JellyTitan/SofleKeyboard/docs/images/build_guide_choc_mx/choc_mx_outline.png

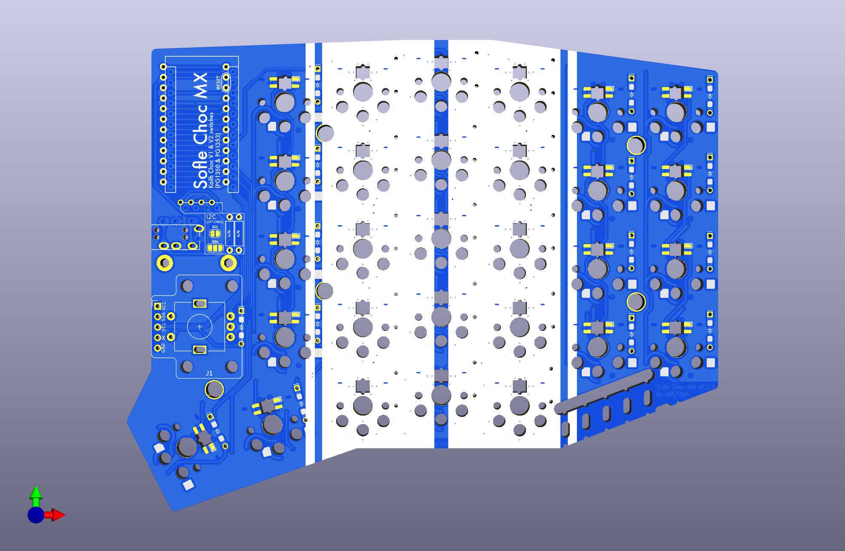
docs/images/build_guide_choc_mx/choc_mx_outline.png
