JellyTitan/SofleKeyboard/(list of files, drawings)

Other design files:
Sofle_Loud/Sofle_Loud/Sofle_Loud.dsn
