JellyTitan/SofleKeyboard/Sofle_Loud/Sofle_Loud/Sofle_Loud.kicad_sch

## KiCad design Sofle_Loud/Sofle_Loud/Sofle_Loud.kicad_sch (2023-05-07)

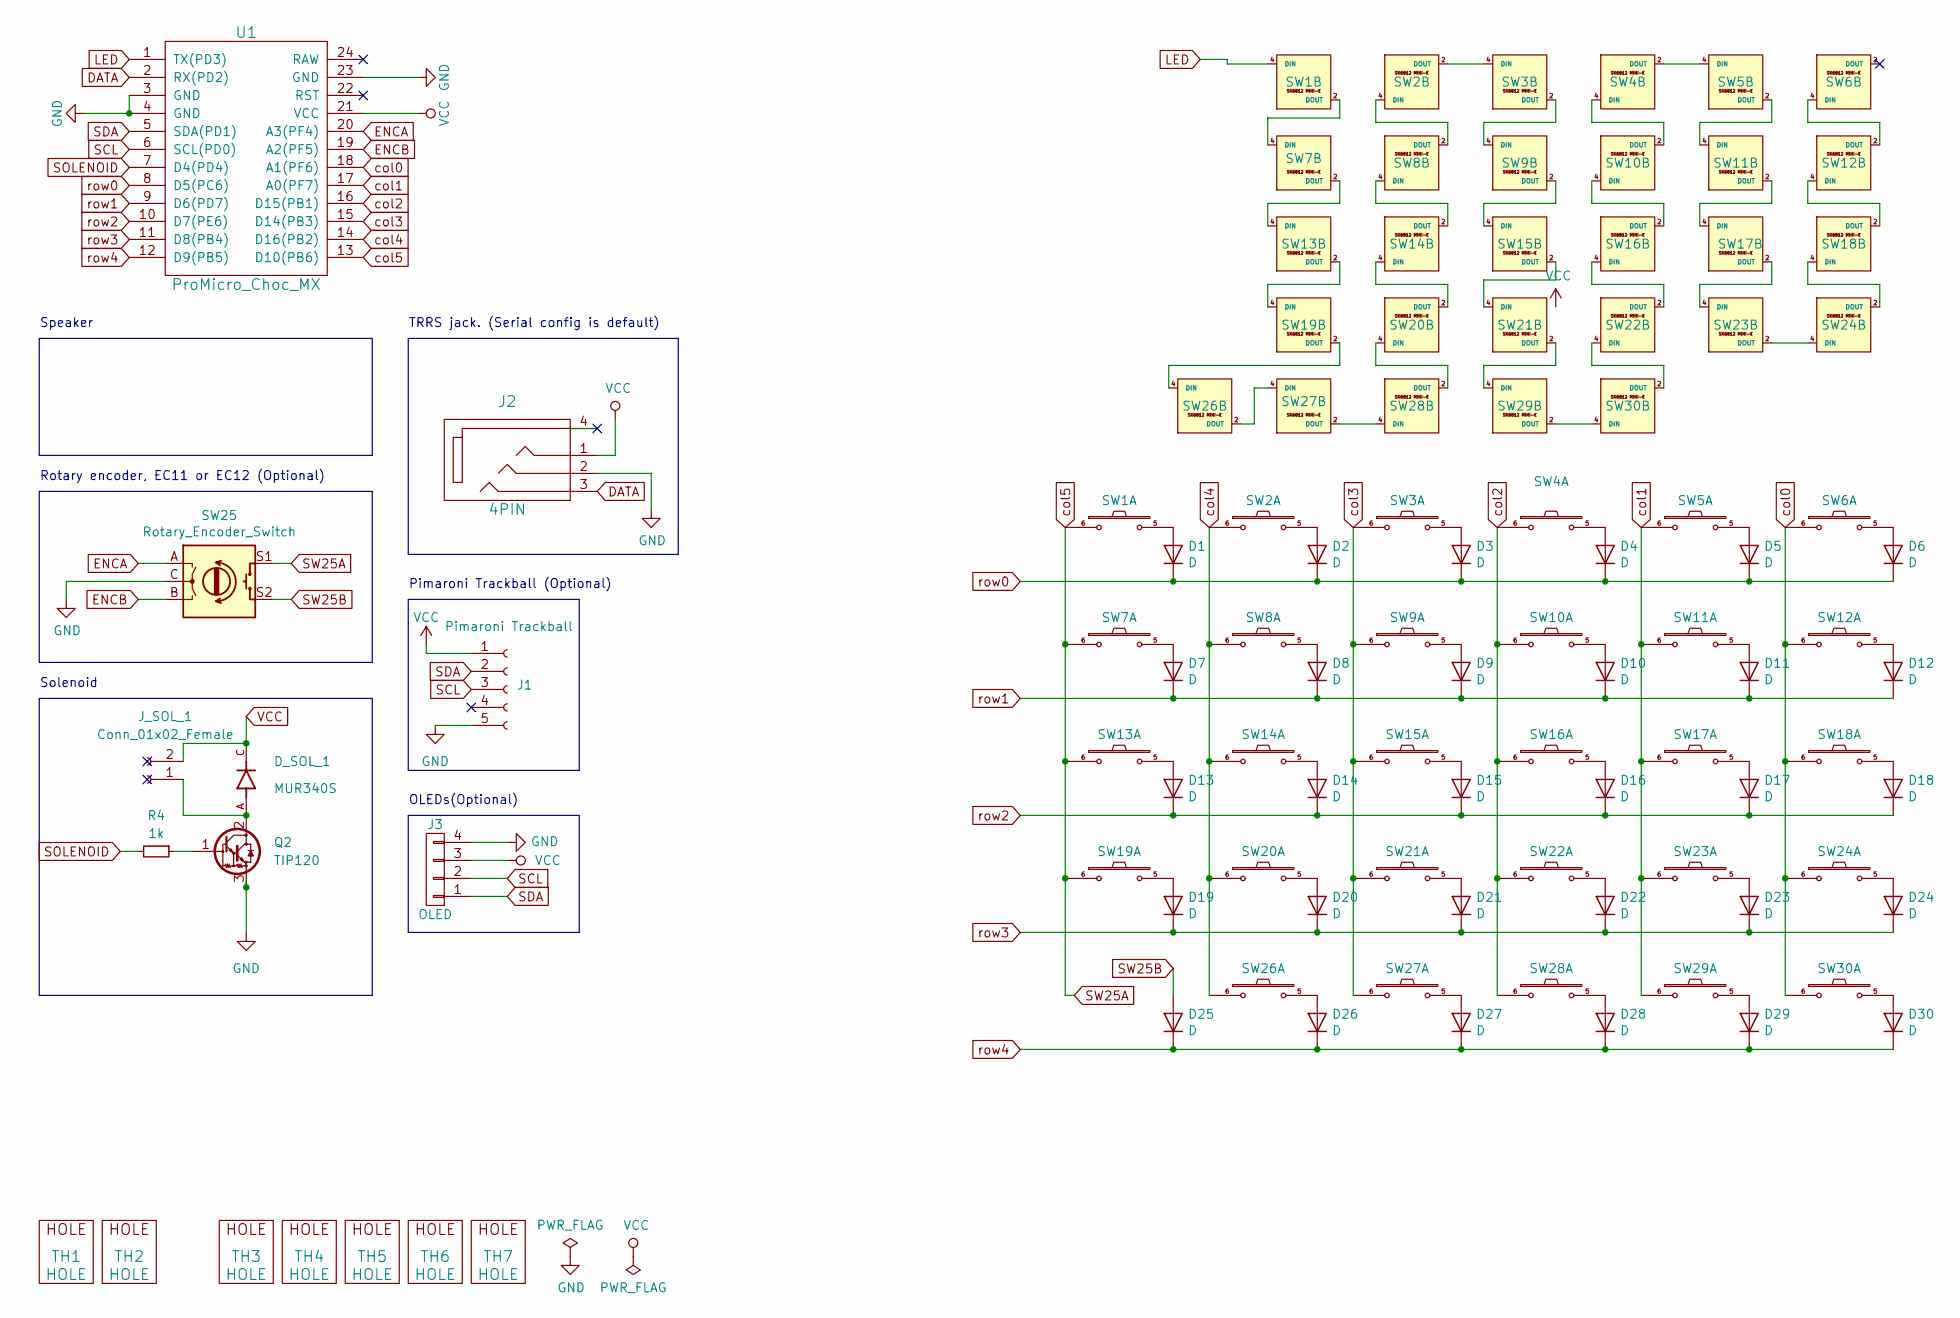
[picture p2: schematic Sofle_Loud.kicad_sch]

Parts:
D1, D2, D3, D4, D5, D6, D7, D8, D9, D10, D11, D12, D13, D14, D15, D16, D17, D18, D19, D20, D21, D22, D23, D24, D25, D26, D27, D28, D29, D30: D; D_SOD-123_DO-35_Hybrid_DoubleSided_V2
D_SOL_1: MUR340S; MUR340S_IN4001_TH_HYBRID; PARTREV L2102
J1: Pimaroni Trackball; Pimaroni_PinHeader_1x05_P2.54mm_Vertical
J2: 4PIN; TRRS_or_TRS_Sofle_Click
J3: OLED; OLED_4Pin_DS_64x128
J_SOL_1: Conn_01x02_Female; PinHeader_1x02_P2.54mm_L-Shaped
Q2: TIP120; TO-220-3_Horizontal_TabUp_noHeatsink
R4: 1k; R_Axial_DIN0309_L9.0mm_D3.2mm_P12.70mm_Horizontal
SW1, SW2, SW3, SW4, SW5, SW6, SW7, SW8, SW9, SW10, SW11, SW12, SW13, SW14, SW15, SW16, SW17, SW18, SW19, SW20, SW21, SW22, SW23, SW24, SW26, SW27, SW28, SW29, SW30: SW_PUSH_LED; Cherry_MX_DS_Hotswap_miniE_1U
SW25: Rotary_Encoder_Switch; RotaryEncoder_Alps_EC11E-Switch_Vertical_H20mm-keebio_modif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
TH1, TH2, TH3, TH4, TH5, TH6, TH7: HOLE; M2_HOLE_PCB_through_hole
U1: ProMicro_Choc_MX

Connections:
DATA: J2.3, U1.2 (RX(PD2))
ENCA: SW25.A, U1.20 (A3(PF4))
ENCB: SW25.B, U1.19 (A2(PF5))
GND: J1.5, J2.2, J3.4, Q2.3 (E), SW25.C, U1.3 (GND), U1.4 (GND), U1.23 (GND)
LED: SW1.4 (DIN), U1.1 (TX(PD3))
unnamed: D1.2 (A), SW1.5
unnamed: D2.2 (A), SW2.5
unnamed: D3.2 (A), SW3.5
unnamed: D4.2 (A), SW4.5
unnamed: D5.2 (A), SW5.5
unnamed: D6.2 (A), SW6.5
unnamed: D7.2 (A), SW7.5
unnamed: D8.2 (A), SW8.5
unnamed: D9.2 (A), SW9.5
unnamed: D10.2 (A), SW10.5
unnamed: D11.2 (A), SW11.5
unnamed: D12.2 (A), SW12.5
unnamed: D13.2 (A), SW13.5
unnamed: D14.2 (A), SW14.5
unnamed: D15.2 (A), SW15.5
unnamed: D16.2 (A), SW16.5
unnamed: D17.2 (A), SW17.5
unnamed: D18.2 (A), SW18.5
unnamed: D19.2 (A), SW19.5
unnamed: D20.2 (A), SW20.5
unnamed: D21.2 (A), SW21.5
unnamed: D22.2 (A), SW22.5
unnamed: D23.2 (A), SW23.5
unnamed: D24.2 (A), SW24.5
unnamed: D26.2 (A), SW26.5
unnamed: D27.2 (A), SW27.5
unnamed: D28.2 (A), SW28.5
unnamed: D29.2 (A), SW29.5
unnamed: D30.2 (A), SW30.5
unnamed: D_SOL_1.A, J_SOL_1.1, Q2.2 (C)
unnamed: Q2.1 (B), R4.1
unnamed: SW1.2 (DOUT), SW7.4 (DIN)
unnamed: SW2.2 (DOUT), SW3.4 (DIN)
unnamed: SW2.4 (DIN), SW8.2 (DOUT)
unnamed: SW3.2 (DOUT), SW9.4 (DIN)
unnamed: SW4.2 (DOUT), SW5.4 (DIN)
unnamed: SW4.4 (DIN), SW10.2 (DOUT)
unnamed: SW10.4 (DIN), SW16.2 (DOUT)
unnamed: SW11.2 (DOUT), SW17.4 (DIN)
unnamed: SW5.2 (DOUT), SW11.4 (DIN)
unnamed: SW6.4 (DIN), SW12.2 (DOUT)
unnamed: SW12.4 (DIN), SW18.2 (DOUT)
unnamed: SW13.2 (DOUT), SW19.4 (DIN)
unnamed: SW7.2 (DOUT), SW13.4 (DIN)
unnamed: SW8.4 (DIN), SW14.2 (DOUT)
unnamed: SW14.4 (DIN), SW20.2 (DOUT)
unnamed: SW15.2 (DOUT), SW21.4 (DIN)
unnamed: SW9.2 (DOUT), SW15.4 (DIN)
unnamed: SW16.4 (DIN), SW22.2 (DOUT)
unnamed: SW17.2 (DOUT), SW23.4 (DIN)
unnamed: SW18.4 (DIN), SW24.2 (DOUT)
unnamed: SW19.2 (DOUT), SW26.4 (DIN)
unnamed: SW20.4 (DIN), SW28.2 (DOUT)
unnamed: SW21.2 (DOUT), SW29.4 (DIN)
unnamed: SW22.4 (DIN), SW30.2 (DOUT)
unnamed: SW23.2 (DOUT), SW24.4 (DIN)
unnamed: SW26.2 (DOUT), SW27.4 (DIN)
unnamed: SW27.2 (DOUT), SW28.4 (DIN)
unnamed: SW29.2 (DOUT), SW30.4 (DIN)
SCL: J1.3, J3.2, U1.6 (SCL(PD0))
SDA: J1.2, J3.1, U1.5 (SDA(PD1))
SOLENOID: R4.2, U1.7 (D4(PD4))
SW25B: D25.2 (A), SW25.S2
VCC: D_SOL_1.C, J1.1, J2.1, J3.3, J_SOL_1.2, SW21.1 (VDD), U1.21 (VCC)
col0: SW6.6, SW12.6, SW18.6, SW24.6, SW30.6, U1.18 (A1(PF6))
col1: SW5.6, SW11.6, SW17.6, SW23.6, SW29.6, U1.17 (A0(PF7))
col2: SW4.6, SW10.6, SW16.6, SW22.6, SW28.6, U1.16 (D15(PB1))
col3: SW3.6, SW9.6, SW15.6, SW21.6, SW27.6, U1.15 (D14(PB3))
col4: SW2.6, SW8.6, SW14.6, SW20.6, SW26.6, U1.14 (D16(PB2))
col5: SW1.6, SW7.6, SW13.6, SW19.6, SW25.S1, U1.13 (D10(PB6))
row0: D1.1 (K), D2.1 (K), D3.1 (K), D4.1 (K), D5.1 (K), D6.1 (K), U1.8 (D5(PC6))
row1: D7.1 (K), D8.1 (K), D9.1 (K), D10.1 (K), D11.1 (K), D12.1 (K), U1.9 (D6(PD7))
row2: D13.1 (K), D14.1 (K), D15.1 (K), D16.1 (K), D17.1 (K), D18.1 (K), U1.10 (D7(PE6))
row3: D19.1 (K), D20.1 (K), D21.1 (K), D22.1 (K), D23.1 (K), D24.1 (K), U1.11 (D8(PB4))
row4: D25.1 (K), D26.1 (K), D27.1 (K), D28.1 (K), D29.1 (K), D30.1 (K), U1.12 (D9(PB5))

Notes on the sheet:
TRRS jack. (Serial config is default)
Pimaroni Trackball (Optional)
Rotary encoder, EC11 or EC12 (Optional)
Solenoid
OLEDs(Optional)
Speaker
