JellyTitan/SofleKeyboard/docs/build_guide_click.md

---
layout: default
title: Sofle Keyboard - build guide (Click)
---

Keyboard
BUILD LOG UPDATE:
5-22-23
Lessons learned/TODO 
* Diode is under keyplate, harder to solder. Can it go elsewhere?
* Soleniod jack is at a dumb spot. it sticks out either way. tuck it up under so you can use dupont connectors.
* The aluminum finish is weird where you tried to go "No solder mask" on the aluminum plates. Maybe a primer? Just do normal stuff
* The USB-c promicro sticks out farther than micro usb.
* The 4 holes in the keyplate need to be smaller, otherwise the posts go through, and that sucks.

BUILD LOG UPDATE:
5-7-23
* Revised Main board outline
* Solenoid should now attach to bottom plate
* Removed speaker 
* Rerouted for new plate cutouts
* Added puck tenting

@todo:
* rebuild all plates with solenoid attached to bottom
* add gold rimmed holes
* Swap in 64x128 screens
* Wait for pico test board to come in.

The Sofle Click is a variant of the Sofle V2 that uses Cherry MX Hot swap switches, supports RGB, 128x64 OLEDs, Solenoids, & piezzo buzzers.

This guide is based off the [http://choc.brianlow.com](Sofle Choc guide by Brian Low). The components are layed out in a similar fashion.

Like the standard Sofle:
  - Hotswap sockets are required. 
  - Per-key RGB remains optional and uses the relatively easy to solder SK6812 MINI-E LEDs.
  - The ProMicro pinout has _not_ changed, so both versions use the same firmware.
  - Key placement has not changed.

This is similar to the Sofle RGB.
I rerouted this board for simplification, and ease of assembly/manufacture were prioritized.
I removed the optional I2C bus so that a TRRS or TRS cable could be used.

Differences from the Sofle V2:
   - Added drill holes above the mini-e hole to allow for easier tweezer placement.
   - Collapsed the double promicro footrpint to a single footprint to simplify routing. (One halfe of the board now has the promicro face up, the other face down.)
   - Added through-hole/Surface mount hybrid footprints for the per-switch diodes.
   - Removed I2C Bus implementation.
   - Moved _all_ mounting holes, both those between keys and those used for the screen cover.
   - Modified thumb cluster outline to accommodate 1.25u thumb keycap.
   - Rounded board corners with a consistent radius. 
   - Added clearly labeled and easily accessible [Pimoroni trackball](https://shop.pimoroni.com/en-us/products/trackball-breakout) tie in footprint.
   - Added teardrops to decrease likelihood of acid traps during manufacture.
   - Added a VCC net to simplify routing.
   - Poka-yoke TRRS footprint by removing unnecessary solder masks.
   - Tweaked diode placement & improved labeling for easier troubleshooting.
   - Removed reset switch and added reset labels. (Modern QMK can put the Promicro into bootloader mode with 'QK_BOOT' key. The hardware reset button would likely only be used once, if at all. There are now labels on the board to short the pins directly if a reset is needed).
   - Resolved the bulk of KiCad DRC violations. (A few edge clearance violations remain - but nothing electrically relevant).
   - @todo Added rally stripes
   - @todo add vent holes in tier 3 plates?
   
Regarding top plates:
   - The top plates from Sofle v1, v2, RGB and Choc versions are not compatible, because the mounting holes have moved to accommodate Choc V2 footprints.
   - The solenoid & the screen are taller than the switch plate, so they have their own separate taller plates.
   - Spacers are intended to pass through the main pcb and screw onto the bottom plates, top plates, and solenoid/oled plates. 

The Sofle Click was designed by [Ryan Neff](https://github.com/JellyTitan), based on the excellent Sofle Choc designed by [Brian Low](https://github.com/brianlow), that is based on the fantastic Sofle RGB by [Dane Evans](https://github.com/DaneEvans) which was based on the original Sofle v2 by [Josef Adamčík](https://github.com/josefadamcik). The Choc V2 footprints came from the well-regarded foostan [kbd library](https://github.com/foostan/kbd). 

## Updated Build Guide and Kits

@todo - write this.

## Bill of materials

The following is needed to build the keyboard:

- **2 PCBs**. Send the zip from `/Gerbers/Choc_mx/choc-mx-gerber-pcb.zip` to a PCB fabrication service. 
The PCB should be 1.6mm thick. I used JLCPCB's default settings only customizing the PCB color. 
@todo refresh Gerbers and update path
@todo: Mention "Lead free" 
@todo: Mention Jlcpcbpart number placement
@todo: seperate jlcpcb gerber?
@todo: revise this -> See [sourcing][sourcing].

- **2 Pro Micro** boards or clones. 5v, 2x12 pins, ATmega32U4 microcontroller. **Don't** buy the Arduino Micro (a different pinout) or Arduino Mini (different microcontroller). You could also use Elite-C which basically Pro Micro with USB-C.
Although QMK supports conversion to pi2040 boards, they are usually not 5v tolerant and may cause issues with the LED's. 
@todo verify this.

- **4x 12 pin headers (and optional sockets)** for Pro Micros. There are several ways to mount Pro Micros to the board. The male pin headers you most likely got with the board can be used to solder it directly to the board. This makes it hard to replace the board if it fails. The micro-USB connector is known to tear off. ~~I socketed the Pro Micro using the diode legs approach [described at splitkb.com][promicrosocketing] with two 12-pin female headers. This is the option descibed in the build guide here. Lastly, [these spring pin headers][springpinheader] are used on similar keyboards and should give a compact, non-permanent connection but have been out of stock for a long time.~~
@todo link to cheap sockets

- **58 Kailh Choc keyboard switches**. Must be [Kailh Choc v1 switches (PG1350)](https://deskthority.net/wiki/Kailh_PG1350_series) of any color, or [Kailh Choc v2](https://deskthority.net/wiki/Kailh_PG1353_series) of any color. The `PG` prefix is often omitted. **Don't** buy , [Kailh Mini Choc](https://deskthority.net/wiki/Kailh_PG1232_series) or [Cherry MX](https://deskthority.net/wiki/Cherry_MX).

- **58 Kailh Choc keyboard switch sockets**. Sockets are specific to the PG1350 switch. The PCB requires sockets. Switches cannot be soldered directly to the board.

- **58 keycaps**. You can use either all in `1u` size but it looks nicer with two `1.5u` for the thumb keys.
@todo link to choc v1 and choc v2 caps. 
@todo - I heard that some MX caps dont' work with choc v2?

- **58 diodes**. 
  -- Surface Mount: 1N4148W surface mount diodes in SOD123 package. Pick any common variation. I used `1N4148WTR` (Digi-Key 1655-1360-1-ND).
  
  Alternately, you can use through  hole diodes, which are easier to solder. These will be _mostly_ hidden under mx keycaps. 
  @todo - modify thumb cluster diode placement? What about rotary diode?
  
  -- Through hole: 1N4148 through hole diode. These are common, any old one should do.

- **2 TRRS connectors**. The same type which is used for Corne, Lily58 etc. Technically even TRS should work if you stick to the default serial communication.

- **1 TRRS cable**. TRS should work if you stick with the default serial communications.

- **8 - 10 silicone bumpers**. Used for feet to keep the keyboard from moving

- **Micro USB Cable** to connect the keyboard to a computer.

Optional components:

- **OLED/s**
  - **2 SSD1306 128x32 OLED display module**. 4-pin, I2C, 0.91". Very common.
  @todo - can we upgrade to 128x64?
  - **2x 4 pin header (and optionally socket)** for OLEDs. These came pre-soldered to the OLED unit. You can solder the OLED directly to the board. Ideally use a socket so you can replace and/or get at the ProMicro underneath. I found 4 pin female headers with half height (~4mm) insulation worked well
  - **2 OLED covers** This should be compatible with the Sofle RGB cover but have not verified
  @todo design these

- **Rotary encoders**
  - **2 Rotary encoders EC11**. If you are not sure take EC11E. Some other variants (EC11K) may have some additional plastic pins for and require mounting holes for them which are not included on the PCB. 
  The standard shaft height is 20mm. For choc low-profile keycaps, this is great. For the taller profile MX keycaps, you lose most of that shaft height, so i would recomend a taller shaft if you can find it. I prefer the Keebio EC11 basic for 20mm shaft. You can find taller shafts at Mouser or Aliexpress. I've yet to find an encoder i don't like. Recently EC12 low-profile encoders have become widely available. They do not have the push switch like the ec11, but otherwise they fit in the same footprint. 
  - **2 matching knobs** for each encoder. Make sure the knob matches the encoder's shaft diameter, depth and shape.
  - **2 diodes 1N4148W SMD or 1N4148 through-hole** the EC11 encoder shafts are pushable and can be used as configurable keys.

- **LEDs**
  - **58 SK6812 MINI-E RGB LEDs**. The LED body 3.2x2.8x1.7mm and with legs is 5.8x2.8. Avoid the non-MINI-E version without the legs. Purchase extra as they are delicate. If you have the option to use a heat gun and solder paste, this makes the install easier. Alternately, you can pay the pcb manufacturer to add them. 

- **Resistors**
  - **2x 4.7kOhm through hole resistors** These only needed if you want to use the less common I2C communication protocol between halves. They are installed in the R1/R2 spots. I have not tested an I2C setup. The firmware on this page uses serial communication and does not require the resistors.

Components that are common on other Sofle variants but are **not** used on this Sofle Choc MX: bottom plate, top plate, M2 spacers and screws.

@todo - rewrite left off here <<<<<
## Tools and materials

- soldering iron and solder
- no-clean flux makes soldering easier
- solder wick or desoldering pump to correct mistakes
- good tweezers
- flush cutters to trim diode legs when socketing the ProMicro
- masking, kapton or electrical tape
- isopropyl-alcohol for cleaning
- screwdriver
- 1.5mm hex key for the set screw on the encoder knob
- multimeter for troubleshooting

## Steps

### Prepare

Make sure you know which side you are working on, and don't make two left hand sides by mistake. Stick a piece of tape on the front side of both PCBs to help remember.

This guide is written in the order I like to install components.

We will start with the components on the back, shortest to tallest:
  - diodes
  - LEDs
  - switch sockets

Then install the components on the front:
  - OLED jumpers
  - ProMicro & socket
  - OLED & socket
  - reset switch
  - TRRS connector
  - encoder

The order of assemby does not matter **except** for these 3 components because they stack on top of one another:
  1. the four OLED jumpers
  2. the Pro Micro
  3. the OLED screen

The build guides for the Sofle and Sofle RGB have some good tips and photos. However there are differences so use this page as your primary reference. In particular, use the ProMicro orientation described on this page.

### Switch Sockets and Diodes

Switch sockets and diodes

These components are placed on the back of the PCB.

Diodes must be oriented with the white band in the direction of the "arrow" symbol on the PCB. I typically tin one pad, place the diode on, apply the soldering iron to the diode leg until it melts the solder underneath and sinks flush with the PCB. Then come back and solder the other leg.

The sockets are the largest and easiest to solder. They are installed on the back of the PCB facing up towards the front of the PCB. Make sure they are flush with the PCB. Heat the metal connector, apply solder and look for the solder to wick down to the PCB. You want a solid joint since this may take some mechanical strain from switch installation and removal.

### The LEDs

LED

LEDs are placed on the back of the PCB. The lens should point up through the PCB so they shine into the bottom of the switch. One leg will have a diagonal cut. This cut leg should be aligned with the triangular marking on the PCB.

To solder: tin one pad, place the LED and hold using tweezers, apply heat to the leg until the solder melts and the LED is flush with the board. Now the remaining legs can be soldered without the component moving. The LEDs are sensitive to heat. Let the LED cool between soldering each leg. Use the lowest heat needed for your solder.

The LEDs are wired in one long chain. If a LED is not working, replace the LED and the LED preceeding it. Sometimes just the output of a LED is damaged. The full chain does not need to be installed if you want to test a partially built board.

LED

### OLED Jumpers

OLED Jumpers

Now we move to the front of the PCB.

The jumpers in the photo should be bridged if using an OLED dispay. The jumpers may not be accessible later in the build depending on how the Pro Micro is attached. Bridge the jumpers on the top side of the board, the same side the ProMicro will be mounted on.

### Pro Micro

Pro Micro

The Pro Micro is installed on the top of the board, upside down and in the marked holes.

* Top of the board: this is the side of the PCB opposite the diodes, LEDs and switch sockets
* Upside down: both Pro Micro components should face the PCB with the mostly plain back facing out
* Marked holes: there are two sets of holes in the PCB, use the holes with the rectangular outline on the top of the board

Double-check your work here. This step is hard to reverse if a mistake is made.

To install a socketed Pro Micro using the diode leg approach [from splitkb.com][promicrosocketing]:

  1. Install the 12-pin female headers on the top of the board in the outlined through holes. Use some tape to temporarily tack them in place. Flip the board over onto a flat, hard surface. While soldering the first pins, push down on the PCB to ensure the headers are perpendicular and fully seated.

  2. Flip the board upright again. Optionally place some tape over the sockets to protect against fusing parts together. Place the Pro Micro upside down on top. Push diodes though the Pro Micro holes, through the tape and seated into the socket below.

  3. Solder the legs to the Pro Micro. Snip off the legs above the Pro Micro.

If you ever need to remove the Pro Micro: do it by gently prying the board up in small increments, working your way around the board. Avoid pressure on the USB connector. The diode leags are quite weak and will usually bend if you pull the Pro Micro off in one action.

### OLED

Install the OLED so it overhangs the Pro Micro. I added electrican's tape to the bottom of the OLED module where it might contact the Pro Micro.

If you are socketing the OLED, install the 4 pin, half height female header on the top of the PCB. Then push the OLED pins into the socket. You may need to trim the OLED pins so the insulation on the female and male headers mate and the OLED sits just above the Pro Micro. The downside to socketing is the OLED isn't as secure in the half height socket. When turning the keyboard upside down I find the OLED will lever away from the Pro Micro somewhat.

### Solder misc components

Use tape to tack each component in place while flipping the board over to solder.

Solder the TRRS connector. You may need to bend the TRRS connector pins 90 degrees so they point down into the PCB. The R1 and R2 locations should remain empty.

Solder the encoder.

### Assemble

- Snap a few switches into the top plate, the corner switches work best

- Place the PCB on a flat surface. This will save some strain on the solder joints in the next step (though they should be able handle it).

- Carefully lower the top plate with switches on the main PCB and push into sockets. Ensure pins are aligned.

- Snap the remaining switches into the top plate pressing into the sockets.

- There are no standoff between the PCB and top plate

- Place the encoder knob on the shaft. Tighten the set screw with a hex key. A small screwdriver for glasses may do in a pinch.

- Optionally add oled covers

- Put at least 4 adhesive rubber feet in the corners so the keyboard is not moving when you type.

## Warnings and disclaimers

- Don't connect or disconnect the TRRS cable when the keyboard is powered. It may short out. Always disconnect the USB cable first.
- Be gentle with micro USB ports on your microcontrollers. They are easy to break.
- Keep in mind that this is a prototype of a DIY keyboard. It's not a polished product.

## Firmware and programming

The Sofle Choc uses [QMK Firmware][qmk_firmware]. Support is not in the main QMK repository [yet](https://github.com/qmk/qmk_firmware/pull/16736). Instead use the [brianlow/qmk_firmware](https://github.com/brianlow/qmk_firmware) fork.
Suggested approach is to build the firmware yourself. You should be familiar with QMK and be able to make it work on your local environment. If not, please [follow the instructions in the documentation][qmkintro]. Note QMK setup is fairly invasive (upgrade every homebrew package on your system) so you might want to consider the [QMK Docker image](https://beta.docs.qmk.fm/using-qmk/guides/development-environments/getting_started_docker) for compiling.

To flash:

- Clone [https://github.com/brianlow/qmk_firmware](https://github.com/brianlow/qmk_firmware)
- Switch to the `choc2` branch with `git checkout choc2`
- Make sure your QMK environment [is setup][qmkintro].
- Make sure halves are not connected together with TRRS cable.
- Connect one half to USB, flash the firmware (always follow the current instructions in the QMK documentation! The command might look something like this: `qmk flash -kb sofle_choc -km default`). Use the reset button to reset the keyboard when you are asked to in console. Some Pro Micros require double-clicking the reset button to enter bootloader mode.
- Connect the second half and flash it in the same way as the previous one.
- Disconnect the USB cable. Connect both halves together with TRRS cable.
- Connect USB cable to the **left** side.
- Enjoy SofleKeyboard!

There is also a firmware version that uses [VIA](https://caniusevia.com/). VIA allows you to quickly change your keymap without flashing or a QMK build environment. I highly recommend it for experimenting. There are few downsides:
- it doesn't support custom logic like a key for switching betwen Mac/Win
- the exporting/importing keymaps has some problems with some multi-chord keys though typically I don't find I need to export/import
- lighting configuration keys only seem to affect lighting on the master side. If you don't change lighting much, a workaround is to plug just the right side in to the computer, change the lighting then plug everrything back normally

To use the VIA firmware

- Clone https://github.com/brianlow/qmk_firmware
- Switch to the `choc-brian` branch with `git checkout choc-brian`
- When flashing use the `choc_brian` keymap: `qmk flash -kb sofle/rev1 -km choc-brian`
- Download the VIA app from https://caniusevia.com/, it should recognize the keyboard when it opens

## Troubleshooting

See the Sofle build guide.

## Links

- [Github with KiCad projects][soflegithub]
- [Layout in KeyboardLayout editor][soflechoclayout]
- [QMK Firmware][qmk_firmware]
- [QMK Configurator][qmk_configurator]

## Default layout

The default layout for the Sofle Choc is in the QMK fork and demonstrates some LED functions.

Default layout for Sofle Choc Keyboard

## Images of keyboard

Keyboard Photo 1

Keyboard Photo 2

## Version History

* v2.1.1 - Top plate: moved the version label to less visible location, widened the area above the encoder. PCB version remains at v2.1
* v2.1 - First published version

## Footnotes
[layoutarticle]: <https://josef-adamcik.cz/electronics/in-search-of-the-best-custom-keyboard-layout.html> "In search of the best custom keyboard layout"
[introductionarticle]: <https://josef-adamcik.cz/electronics/let-me-introduce-you-sofle-keyboard-split-keyboard-based-on-lily58.html> "Let me introduce you SofleKeyboard - a split keyboard based on Lily58 and Crkbd"
[soflelayout]: http://www.keyboard-layout-editor.com/#/gists/76efb423a46cbbea75465cb468eef7ff "Sofle Keyboard layout at keyboard-layout-editor.com"
[soflechoclayout]: http://www.keyboard-layout-editor.com/#/gists/5604075ad16c10a8c634828c5911d2b6 "Sofle Choc Keyboard layout at keyboard-layout-editor.com"
[soflegerber]: https://github.com/josefadamcik/SofleKeyboard/releases "SofleKeyboard - gerber files"
[qmk_firmware]: https://github.com/qmk/qmk_firmware/ "QMK firmware"

[qmk_configurator]: https://config.qmk.fm/#/sofle/rev1/LAYOUT "QMK configurator"
[springpinheader]: <https://yushakobo.jp/shop/a01mc-00/> "Spring pin headers - Japanese"
[qmkprotonc]: https://qmk.fm/proton-c/ "QMK Proton-C"
[promicrosocketing]: <https://docs.splitkb.com/hc/en-us/articles/360011263059> "How do I socket a microcontroller? by splitkb.com"
[qmkintro]: <https://beta.docs.qmk.fm/newbs/newbs_getting_started> "QMK getting started"
[qmkhandedness]: <https://docs.qmk.fm/#/feature_split_keyboard?id=setting-handedness> "QMK firmware - setting handedness"
[manufacturingproblems]: https://josef-adamcik.cz/electronics/corne-keyboard-build-log.html#manufacturing-at-jlcpcb---update-27112019 "Possible problems when manufacturing top plate for Corne"
[nooledlag]: https://github.com/qmk/qmk_firmware/issues/7522 "No OLED lag bug"
[soflegithub]: https://github.com/josefadamcik/SofleKeyboard "SofleKeyboard - KiCad project on Github.com"
[sourcing]: <{{ site.baseurl }}/sourcing_parts.html> "Sourcing parts"
