JellyTitan/SofleKeyboard/(commit log)

2023-03-18 Cloned ChocV2 MX variant from sofle choc Replaced Choc V1 footprints with Choc V2 footprints
    [SofleKeyboard.dsn, SofleKeyboard.kicad_pcb, SofleKeyboard.sch, SofleKeyboardTopPlate.kicad_pcb]
2023-03-18 Tied front zone to VCC Updated LED footprint with compact DS variant
    [SofleKeyboard.kicad_pcb]
2023-03-18 Swapped out SMD Diode footprint for through-hole SMD hybrid footprint
    [SofleKeyboard.kicad_pcb, SofleKeyboard.kicad_sch]
2023-03-18 Wiped switch vias and traces for reroute
    [SofleKeyboard.kicad_pcb]
2023-03-18 Diodes moved to prevent footprint overlaps
    [SofleKeyboard.kicad_pcb]
2023-03-19 Switch footprint overhaul switch rerouteing
    [SofleKeyboard.kicad_pcb]
2023-03-19 More routing
    [SofleKeyboard.kicad_pcb]
2023-03-20 Switch footprint rework for consistent clearance
2023-03-20 Hole size tweaks for JLCPCB and DRC
2023-03-20 ProMicro footprint variant created backside shifted .25 -x to resolve DRC clearance violations
2023-03-20 Created TRRS footprint variant Poka-yoke by removing unnecessary trrs masks
    [SofleKeyboard.kicad_sch]
2023-03-20 Revised mini-e footprint for elegant routing
2023-03-21 Sent this version out for production at jlcpcb
    [SofleKeyboard-B_Cu.gbl, SofleKeyboard-B_Mask.gbs, SofleKeyboard-B_Silkscreen.gbo, SofleKeyboard-Edge_Cuts.gm1, SofleKeyboard-F_Cu.gtl, SofleKeyboard-F_Mask.gts, SofleKeyboard-F_Silkscreen.gto, SofleKeyboard-NPTH.drl]
2023-03-21 Added double OLED footprint and removed jumpers
    [SofleKeyboard.kicad_sch]
2023-03-23 OLED second socket added Updated schematic to remove jumpers for DS oled socket Increased Promicro footrprint spacing Cleaned up promicro routing Simplified promicro footprint for poke-yoke soldering
    [SofleKeyboard.kicad_sch]
2023-03-24 Removed reset button added poke-yoke reset graphics Tweaked I2C component location
    [SofleKeyboard.kicad_sch]
2023-03-25 Fixed I2C bus rerouted and cleaned up teardrops labeleing tweaks DRC
    [SofleKeyboard.kicad_sch]
2023-03-25 Moved TRRS jack and screen cover mounting hole to fix conflict with Pimoroni mounting holes
2023-03-26 Tweaked OLED footprint
    [SofleKeyboard.kicad_sch]
2023-03-27 Added diode bender
2023-03-28 Rotated 1.25u thumb key by 3deg Moved thumb key ~1mm left and down to resolve MX key overlap when using 1.25u keycaps
2023-03-31 Build guide cleanup (wip)
    [SofleKeyboard.kicad_sch]
2023-03-31 Removed unused B.Silkscreen jlcpcb order number
2023-03-31 Enlarged choc v2 3rd pin hole
2023-03-31 Enlarged hotswap pads for easier soldering
2023-03-31 Reduced diode diameter from 1.2 to .9
2023-04-02 Added larger mini-e ground pin markings The small ground pin markings were obscured during sm soldering Added note about origin of choc V2 footprint from Foostan kbd library
2023-04-03 Right aligned all diodes and rerouted
2023-04-05 Consolidated I2C Components into one area
2023-04-05 Aligned thumb diodes for easier debugbugging
2023-04-05 Rally stripes added thumb diode placement tweak
    [SofleKeyboard-B_Cu.gbl, SofleKeyboard-B_Mask.gbs, SofleKeyboard-B_Silkscreen.gbo, SofleKeyboard-Edge_Cuts.gm1, SofleKeyboard-F_Cu.gtl, SofleKeyboard-F_Mask.gts, SofleKeyboard-F_Silkscreen.gto, SofleKeyboard-NPTH.drl]
2023-04-05 Gerber regen and doc update
    [SofleKeyboard-B_Cu.gbl, SofleKeyboard-B_Mask.gbs, SofleKeyboard-B_Silkscreen.gbo, SofleKeyboard-Edge_Cuts.gm1, SofleKeyboard-F_Cu.gtl, SofleKeyboard-F_Mask.gts, SofleKeyboard-F_Silkscreen.gto, SofleKeyboard-NPTH.drl]
2023-04-06 Library cleanup and consolidation
    [SofleKeyboard.kicad_sch]
2023-04-06 Converted i2c jumper pads to through hole and moved diodes
    [SofleKeyboard.kicad_sch]
2023-04-08 'Sofle loud' first commit
    [Sofle_Loud.dsn, Sofle_Loud.kicad_sch, Sofle_Loud.sch]
2023-04-08 Updated transistor footprint Added extra room for heatsink Rebuilt outline Wired solenoid and piezzo
    [Sofle_Loud.kicad_sch]
2023-04-08 Footprint cleanup for plates Added markings to OLEDs indicating screen start/end offset oleds 3mm from edge of board rotated transistor for more slop on heatsinks Created Double sided TRRS footprint 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
    [Sofle_Loud.kicad_sch]
2023-04-09 Adding 2nd tier keyplate
    [Sofle_Loud.kicad_sch, Top.kicad_pcb, Top.kicad_sch]
2023-04-10 SENT THIS VERSION OUT FOR PRODUCTION created key plates created top plates above key plates tweaked component layout to make room for plate M2 f-f spacers
    [Sofle_Loud-B_Cu.gbl, Sofle_Loud-B_Mask.gbs, Sofle_Loud-B_Silkscreen.gbo, Sofle_Loud-Edge_Cuts.gm1, Sofle_Loud-F_Cu.gtl, Sofle_Loud-F_Mask.gts, Sofle_Loud-F_Silkscreen.gto, Sofle_Loud-NPTH.drl]
2023-04-10 Generated bottom plate did not send out for production yet
    [Sofle_loud_bottom-B_Cu.gbr, Sofle_loud_bottom-B_Mask.gbr, Sofle_loud_bottom-B_Paste.gbr, Sofle_loud_bottom-B_Silkscreen.gbr, Sofle_loud_bottom-Edge_Cuts.gbr, Sofle_loud_bottom-F_Cu.gbr, Sofle_loud_bottom-F_Mask.gbr, Sofle_loud_bottom-F_Paste.gbr]
2023-04-10 Added CKBD submodule wired up 3d model path for KDB submodule Updated TRRS 3d model Updated TRRS footprint masks
2023-04-23 Improved diode labeling Improved switch labeling increased diode labeling size for better visibility Added 3d models
2023-04-23 Updated pimoroni markings Added 3d models to components
    [Sofle_Loud.kicad_sch]
2023-04-23 Created 3d models from case plates
    [Sofle_loud_bottom.kicad_pcb]
2023-04-24 Improved tip120 pcb markings
2023-04-24 Added extra plates to 3d model
2023-04-25 Silkscreen mcu tweaks
2023-04-26 Fixed reveresed OLED pins
    [Sofle_Loud.kicad_sch]
2023-05-01 Checkpoint commit
    [Sofle_loud_bottom 2.kicad_sch, Top 2.kicad_sch, sofle_click_keyplate_2ndlayer 2.kicad_sch, sofle_click_keyplate_A 2.kicad_sch]
2023-05-07 Added tenting puck holes
2023-05-07 Revised Main board outline Solenoid should now attach to bottom plate Removed speaker Rerouted for new plate cutouts
    [Sofle_Loud.kicad_sch]
2023-05-23 Updated with lessons learned from prototype build
2024-03-03 First pass at comparison graphics Revised all keyboards to use outline stubbs Generated nested SVG's and color pallete
    [SofleKeyboard.kicad_pcb]
